Helge-Stein-Group/coco_coater/software/paper_rawdata/coatings/LFP90_150_UNIFORM.jpg

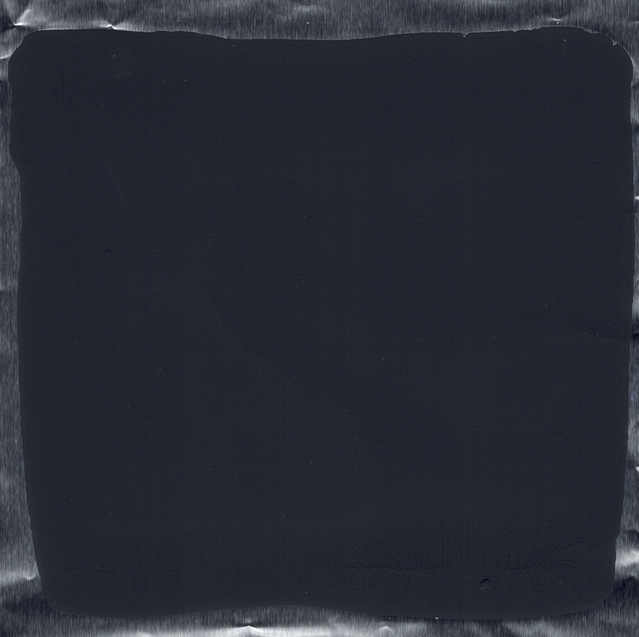
software/paper_rawdata/coatings/LFP90_150_UNIFORM.jpg
