Helge-Stein-Group/coco_coater/hardware/step/Coco_BladeContainer.step

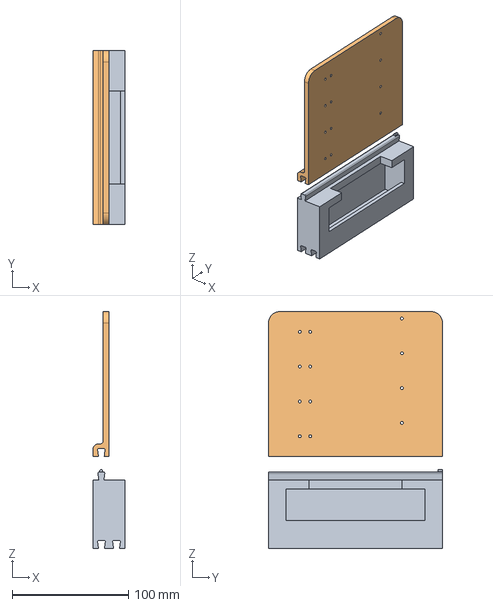
[picture p2: CAD file, 2026-10-19]
hardware/step/Coco_BladeContainer.step
28.0 x 150.0 x 204.2 mm
