Helge-Stein-Group/coco_coater/hardware/step/Coco_BladeHolder.step

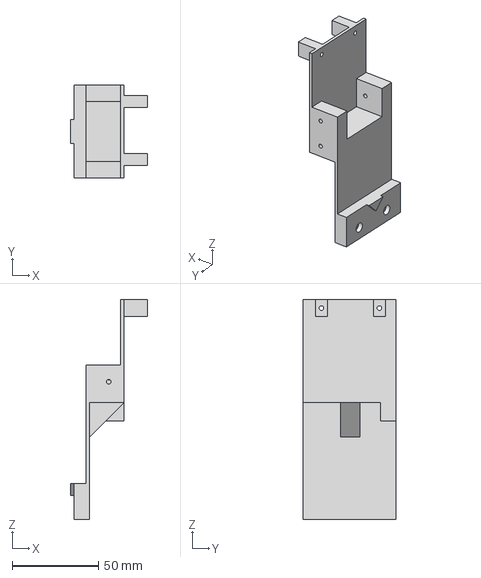
[picture p3: CAD file, 2026-04-28]
hardware/step/Coco_BladeHolder.step
44.5 x 54.3 x 127.9 mm
