Helge-Stein-Group/coco_coater/hardware/step/Coco_VacuumPlate_Corners_RailSystem.step

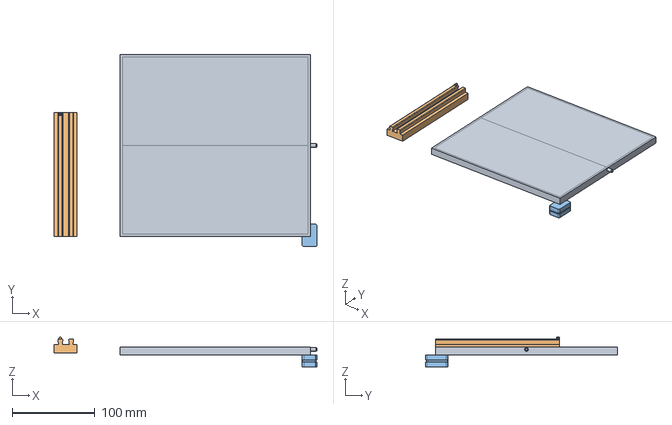
[picture p4: CAD file, 2026-04-28]
hardware/step/Coco_VacuumPlate_Corners_RailSystem.step
317.6 x 232.0 x 35.8 mm
