Helge-Stein-Group/coco_coater/(list of files, cad)

Other CAD files:
hardware/fusion360/Coco_BladeContainer.f3d
hardware/fusion360/Coco_BladeHolder.f3d
hardware/fusion360/Coco_VacuumPlate_Corners_RailSystem.f3d
hardware/stl/Coco_BladeContainer.stl
hardware/stl/Coco_BladeHolder.stl
hardware/stl/Coco_VacuumPlate_Corners_RailSystem.stl
