Helge-Stein-Group/coco_coater/software/paper_rawdata/point_repeatability_validation/RandomField_Repeatability.xlsx

sample_name | point_id | x_coat_mm | y_coat_mm | z_rep_1_um | z_rep_2_um | z_rep_3_um | z_rep_4_um | z_rep_5_um | z_rep_6_um | z_rep_7_um | z_rep_8_um | z_rep_9_um | z_rep_10_um | z_rep_11_um | z_rep_12_um | z_rep_13_um | z_rep_14_um | z_rep_15_um | z_rep_16_um | z_rep_17_um | z_rep_18_um | z_rep_19_um | z_rep_20_um | z_rep_21_um | z_rep_22_um | z_rep_23_um | z_rep_24_um | z_rep_25_um | z_rep_26_um | z_rep_27_um | z_rep_28_um | z_rep_29_um | z_rep_30_um | z_rep_31_um | z_rep_32_um | z_rep_33_um | z_rep_34_um | z_rep_35_um | z_rep_36_um | z_rep_37_um | z_rep_38_um | z_rep_39_um | z_rep_40_um | z_rep_41_um | z_rep_42_um | z_rep_43_um | z_rep_44_um | z_rep_45_um | z_rep_46_um | z_rep_47_um | z_rep_48_um | z_rep_49_um | z_rep_50_um | z_rep_51_um | z_rep_52_um | z_rep_53_um | z_rep_54_um | z_rep_55_um | z_rep_56_um
random_repro_021225_20x1000 | 0 | 197.14 | 115.51 | 30 | 20 | 20 | 20 | 20 | 20 | 20 | 20 | 20 | 10 | 20 | 20 | 20 | 20 | 20 | 20 | 20 | 20 | 20 | 20 | 20 | 20 | 20 | 20 | 20 | 20 | 20 | 20 | 20 | 20 | 20 | 20 | 20 | 30 | 20 | 20 | 20 | 20 | 20 | 20 | 20 | 20 | 20 | 20 | 20 | 20 | 20 | 20 | 20 | 20 | 20 | 20 | 20 | 20 | 20 | 20
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
