Helge-Stein-Group/coco_coater/software/paper_rawdata/micrometer_validation/ReferenceComparison.xlsx

label | x_mm | y_mm | z_coating_1_mm | z_coating_2_mm | z_coating_3_mm | z_blank_1_mm | z_blank_2_mm | z_blank_3_mm | diff_means_um | micrometer_mean_um | Micrometer M1 | Micrometer M2 | Micrometer M2
x1y1 | 33 | 189 | 0.06 | 0.08 | 0.08 | 0.01 | 0.02 | 0.02 | 56.66666667 | 45.33333333 | 46 | 45 | 45
x2y1 | 51 | 189 | 0.04 | 0.05 | 0.05 | -0.02 | -0.01 | -0.02 | 63.33333333 | 49.66666667 | 50 | 50 | 49
x3y1 | 67 | 189 | 0.04 | 0.05 | 0.05 | -0.02 | -0.02 | -0.02 | 66.66666667 | 55.66666667 | 57 | 56 | 54
x4y1 | 82 | 189 | 0.04 | 0.05 | 0.04 | -0.02 | -0.02 | -0.01 | 60 | 51.33333333 | 52 | 51 | 51
x5y1 | 98 | 189 | 0.04 | 0.05 | 0.04 | -0.03 | -0.03 | -0.02 | 70 | 54.66666667 | 55 | 55 | 54
x6y1 | 111 | 189 | 0.04 | 0.04 | 0.05 | -0.03 | -0.02 | -0.02 | 66.66666667 | 55.33333333 | 55 | 55 | 56
x1y2 | 33 | 174 | 0.05 | 0.05 | 0.04 | 0 | -0.01 | -0.01 | 53.33333333 | 42.33333333 | 44 | 42 | 41
x2y2 | 51 | 174 | 0.04 | 0.04 | 0.03 | -0.02 | -0.02 | -0.03 | 60 | 49 | 49 | 49 | 49
x3y2 | 67 | 174 | 0.04 | 0.04 | 0.02 | -0.03 | -0.02 | -0.02 | 56.66666667 | 47.66666667 | 48 | 48 | 47
x4y2 | 82 | 174 | 0.05 | 0.04 | 0.05 | -0.01 | -0.02 | -0.02 | 63.33333333 | 51.66666667 | 52 | 52 | 51
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
