Helge-Stein-Group/coco_coater/software/paper_rawdata/gaugeblock_validation/GaugeBlockValidation.xlsx

Sheet: Point1
measurement_index | z_reference_mm | z_block_mm | Point | 1
1 | 0 | 1.01 | X [mm] | 110
2 | 0 | 1.01 | Y [mm] | 110
3 | 0 | 1.01 | N measurements | 10
4 | 0 | 1.01 | Nominal value [µm] | 1000
5 | 0 | 1.01
6 | 0 | 1.01
7 | 0 | 1.01
8 | 0 | 1.01
9 | 0 | 1.01
10 | 0 | 1.01

Sheet: Point2
measurement_index | z_reference_mm | z_block_mm | Point | 2
1 | 0.05 | 1.06 | X [mm] | 50
2 | 0.05 | 1.06 | Y [mm] | 50
3 | 0.05 | 1.06 | N measurements | 10
4 | 0.05 | 1.06 | Nominal value [µm] | 1000
5 | 0.05 | 1.06
6 | 0.05 | 1.06
7 | 0.05 | 1.06
8 | 0.05 | 1.06
9 | 0.05 | 1.06
10 | 0.05 | 1.05

Sheet: Point3
measurement_index | z_reference_mm | z_block_mm | Point | 3
1 | 0.01 | 1.01 | X [mm] | 50
2 | 0.01 | 1.01 | Y [mm] | 150
3 | 0.01 | 1.01 | N measurements | 10
4 | 0.01 | 1.01 | Nominal value [µm] | 1000
5 | 0.01 | 1.01
6 | 0.01 | 1.01
7 | 0 | 1.01
8 | 0 | 1.01
9 | 0 | 1.01
10 | 0 | 1.01

Sheet: Point4
measurement_index | z_reference_mm | z_block_mm | Point | 4
1 | 0 | 1.02 | X [mm] | 150
2 | 0 | 1.01 | Y [mm] | 50
3 | 0 | 1.01 | N measurements | 10
4 | 0 | 1.01 | Nominal value [µm] | 1000
5 | 0 | 1.01
6 | 0 | 1.01
7 | 0 | 1.01
8 | 0 | 1.01
9 | 0 | 1.01
10 | 0 | 1.01
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
