Helge-Stein-Group/coco_coater/software/paper_rawdata/coatings/Coating_Results.xlsx

Sheet: field4_Test3_20251201_165116
sample_name | x_mm | y_mm | z_blank_mm | z_dry_mm | z_actual_gap_mm | thickness_mm | thickness_um | coated_yes_no | zone_index | set_speed_mm_s | set_height_um
Test3 | 48 | 218 | 0.04 | 0.05 | 0.72 | 0.01 | 10 | ja | 1 | 2 | 700
Test3 | 62 | 218 | 0.05 | 0.06 | 0.71 | 0.01 | 10 | ja | 1 | 2 | 700
Test3 | 76 | 218 | 0.05 | 0.05 | 0.71 | 0 | 0 | nein | 1 | 2 | 700
Test3 | 90 | 218 | 0.04 | 0.04 | 0.72 | 0 | 0 | nein | 1 | 2 | 700
Test3 | 104 | 218 | 0.03 | 0.04 | 0.73 | 0.01 | 10 | ja | 1 | 2 | 700
Test3 | 118 | 218 | 0.05 | 0.05 | 0.71 | 0 | 0 | nein | 1 | 2 | 700
Test3 | 132 | 218 | 0.06 | 0.07 | 0.7 | 0.01 | 10 | ja | 1 | 2 | 700
Test3 | 48 | 204 | 0.04 | 0.27 | 0.7 | 0.23 | 230 | ja | 1 | 2 | 700
Test3 | 62 | 204 | 0.04 | 0.24 | 0.7 | 0.2 | 200 | ja | 1 | 2 | 700
Test3 | 76 | 204 | 0.04 | 0.2 | 0.7 | 0.16 | 160 | ja | 1 | 2 | 700
Test3 | 90 | 204 | 0.03 | 0.23 | 0.71 | 0.2 | 200 | ja | 1 | 2 | 700
Test3 | 104 | 204 | 0.02 | 0.23 | 0.72 | 0.21 | 210 | ja | 1 | 2 | 700
Test3 | 118 | 204 | 0.03 | 0.2 | 0.71 | 0.17 | 170 | ja | 1 | 2 | 700
Test3 | 132 | 204 | 0.04 | 0.23 | 0.7 | 0.19 | 190 | ja | 1 | 2 | 700
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
